thisjt/gate/images/circuit.png

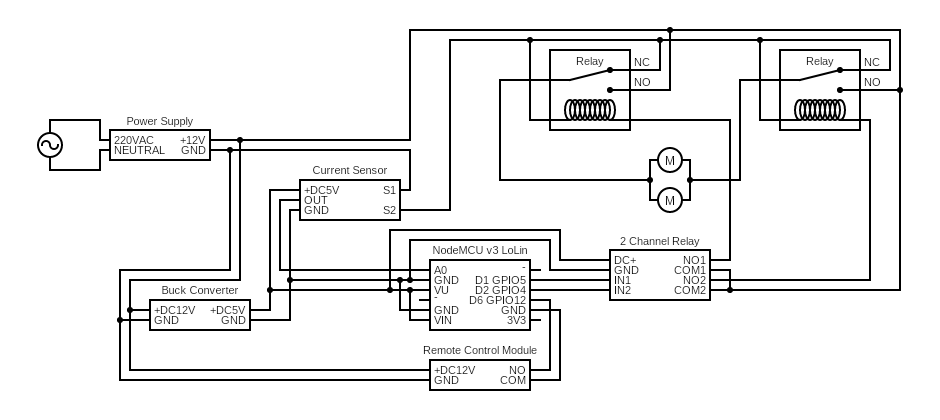
images/circuit.png
